Rahmawati612/RANCANG-BANGUN-TONGKAT-PINTAR-DETEKSI-OBJEK-DENGAN-CNN-MOBILENET-DAN-NAVIGASI-BAGI-TUNANETRA/README.md

# RANCANG-BANGUN-TONGKAT-PINTAR-DETEKSI-OBJEK-DENGAN-CNN-MOBILENET-DAN-NAVIGASI-BAGI-TUNANETRA
Kode Program Skripsi RANCANG BANGUN TONGKAT PINTAR DETEKSI OBJEK DENGAN CNN MOBILENET DAN NAVIGASI BAGI TUNANETRA
